Cvarc-Xtal/xiegu_g90_panel/esp32s3-panel-xiegu-g90.pdf

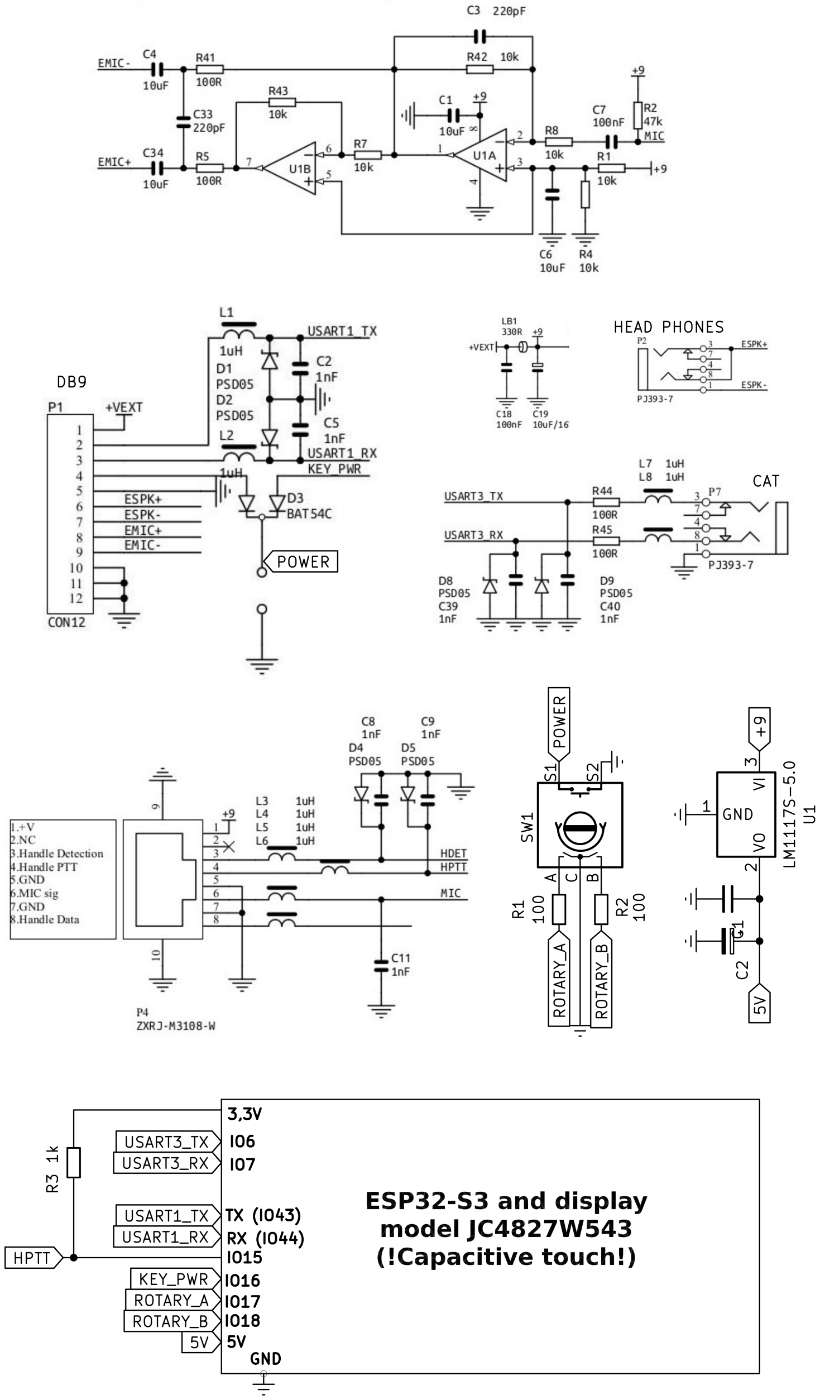
[picture p5: page 1]
