Cvarc-Xtal/xiegu_g90_panel/arduino/esp32-s3-g90-xiegu-full/JC4827W543/JC4827W543-2.png

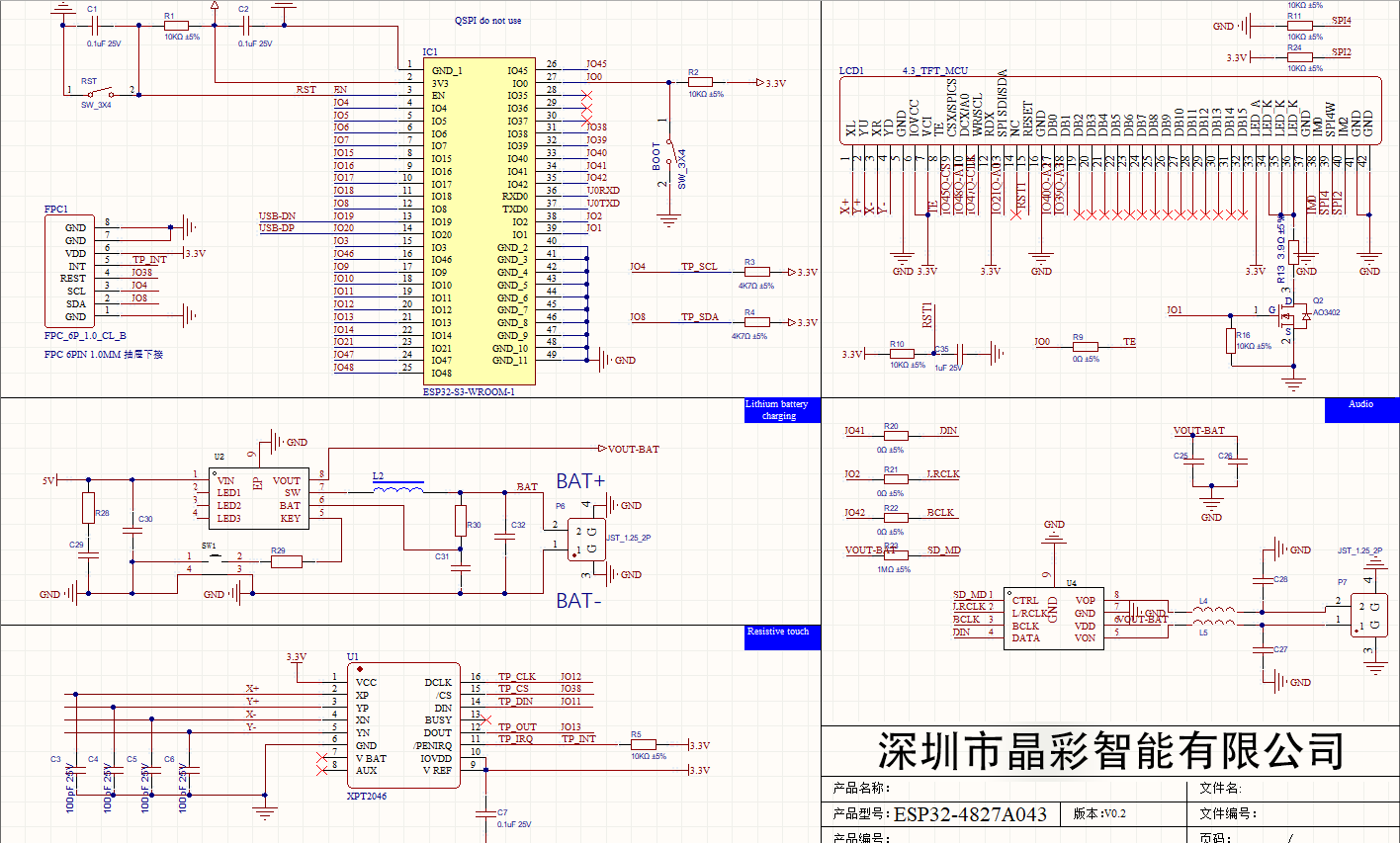
arduino/esp32-s3-g90-xiegu-full/JC4827W543/JC4827W543-2.png
