Cvarc-Xtal/xiegu_g90_panel/(threads)

Thread 1 (2025-02-13):

[program] Можно ли достичь добавления функций FT8, декодирования и кодирования.

icivon, 2025-02-13:
Можно ли достичь добавления функций FT8, декодирования и кодирования. Эта программа, функция декодирования CW все еще существует?

icivon, 2025-02-14:
Этот проект очень хороший, и я думаю, что он может заменить GSOC. Я также использую радио xiegu g90.

Cvarc-Xtal, 2025-02-14:
> Этот проект очень хороший, и я думаю, что он может заменить GSOC. Я также использую радио xiegu g90.

Да, в планах на основе этого проекта сделать почти  полноценный аналог GSOC с полосой до 100 кгц и нормальной панорамой. Изучив принципиальную схему g90, понял, что это возможно и не очень сложно.

icivon, 2025-02-14:
Недавно я искал информацию о Xiegu G90 и обнаружил этот проект. Чувствую себя очень хорошо. Хотелось бы попробовать изготовить. В последнее время изучается компиляция программы Arduion. У вас есть электронная почта, можно ли общаться друг с другом по электронной почте? Содержание здесь открыто и не подходит для частого общения.

Cvarc-Xtal, 2025-02-14:
> Недавно я искал информацию о Xiegu G90 и обнаружил этот проект. Чувствую себя очень хорошо. Хотелось бы попробовать изготовить. В последнее время изучается компиляция программы Arduion. У вас есть электронная почта, можно ли общаться друг с другом по электронной почте? Содержание здесь открыто и не подходит для частого общения.

Пишите сюда. По возможности отвечу.

icivon, 2025-02-14:
Ну, как радиолюбитель, приятно общаться с вами по технологиям. Спасибо, что поделились. Надеемся, что проект станет лучше. Если у меня возникнут проблемы с производством, я надеюсь, что вы поможете. - Спасибо. 73
