Cvarc-Xtal/xiegu_g90_panel/arduino/esp32-s3-g90-xiegu-full/include/images.h

// 'wifi-8x', 15x15px
const uint16_t wifi_on [] PROGMEM = {
  0x07e0, 0x1582, 0x15a2, 0x15a2, 0x15a2, 0x15a2, 0x15a2, 0x15a2, 0x15a2, 0x15a2, 0x15a2, 0x15a2, 0x0dc1, 0x0540, 0x0000, 0x15a2, 
  0x15a2, 0x15a2, 0x15a2, 0x15a2, 0x15a2, 0x15a2, 0x15a2, 0x15a2, 0x15a2, 0x15a2, 0x15a2, 0x15a2, 0x15a2, 0x04c0, 0x15a2, 0x15a2, 
  0x15a2, 0x15a2, 0x15a2, 0x15a2, 0x0dc1, 0x0d81, 0x1582, 0x15c2, 0x15a2, 0x15a2, 0x15a2, 0x15a2, 0x0d81, 0x15a2, 0x15a2, 0x15c2, 
  0x0000, 0x0000, 0x0000, 0x0000, 0x0000, 0x0000, 0x0000, 0x0000, 0x0dc1, 0x15a2, 0x15a2, 0x0540, 0x0000, 0x0000, 0x0000, 0x0000, 
  0x0000, 0x0000, 0x0000, 0x0000, 0x0000, 0x0000, 0x0000, 0x0000, 0x0000, 0x0000, 0x0000, 0x0000, 0x0000, 0x0400, 0x0da1, 0x15c2, 
  0x15a2, 0x15a2, 0x15a2, 0x15a2, 0x15a2, 0x15a2, 0x0540, 0x0000, 0x0000, 0x0000, 0x0000, 0x0000, 0x1562, 0x15a2, 0x15a2, 0x15a2, 
  0x15a2, 0x15a2, 0x15a2, 0x15a2, 0x15a2, 0x15c2, 0x0000, 0x0000, 0x0000, 0x0000, 0x0000, 0x0d61, 0x15a2, 0x15a2, 0x15a2, 0x15a2, 
  0x15a2, 0x15a2, 0x15a2, 0x15a2, 0x1582, 0x0000, 0x0000, 0x0000, 0x0000, 0x0000, 0x0540, 0x15c2, 0x15a2, 0x15a2, 0x15e2, 0x15e2, 
  0x15c2, 0x15a2, 0x15a2, 0x04c0, 0x0000, 0x0000, 0x0000, 0x0000, 0x0000, 0x0000, 0x0000, 0x0000, 0x0000, 0x0000, 0x0000, 0x0000, 
  0x0000, 0x0000, 0x0000, 0x0000, 0x0000, 0x0000, 0x0000, 0x0000, 0x0000, 0x0000, 0x0000, 0x0000, 0x0000, 0x0000, 0x0000, 0x0000, 
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
  0x0000, 0x0000, 0x0000, 0x0000, 0x0000, 0x0000, 0x0000, 0x0000, 0x0000, 0x0000, 0x0000, 0x0000, 0x0000, 0x0000, 0x0000, 0x0000, 
  0x0000, 0x0000, 0x0000, 0x0000, 0x0000, 0x0000, 0x0000, 0x0000, 0x0000, 0x0000, 0x0000, 0x0000, 0x0000, 0x0000, 0x0000, 0x0000, 
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
};
