Cvarc-Xtal/xiegu_g90_panel/(commit log)

2025-02-04 new file: esp32s3-panel-xiegu-g90.pdf
2025-02-04 new file: 1.png new file: 2.png modified: README.md deleted: arduino/esp32s3-panel-xiegu-g90.pdf
2025-02-04 modified: README.md deleted: arduino/esp32s3-panel-xiegu-g90.pdf
2025-02-11 modified: arduino/esp32-s3-g90-xiegu-full/fft.h modified: arduino/esp32-s3-g90-xiegu-full/g90.h modified: arduino/esp32-s3-g90-xiegu-full/global.h modified: arduino/esp32-s3-g90-xiegu-full/screens.h 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
2025-02-12 modified: arduino/esp32-s3-g90-xiegu-full/esp32-s3-g90-xiegu-full.ino modified: arduino/esp32-s3-g90-xiegu-full/g90.h modified: arduino/esp32-s3-g90-xiegu-full/global.h modified: arduino/esp32-s3-g90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
2025-02-13 modified: README.md modified: arduino/esp32-s3-g90-xiegu-full/esp32-s3-g90-xiegu-full.ino modified: arduino/esp32-s3-g90-xiegu-full/tools.h
2025-02-13 modified: arduino/esp32-s3-g90-xiegu-full/screens.h
2025-02-19 modified: arduino/esp32-s3-g90-xiegu-full/_tmp.h modified: arduino/esp32-s3-g90-xiegu-full/ci_v.h modified: arduino/esp32-s3-g90-xiegu-full/esp32-s3-g90-xiegu-full.ino modified: arduino/esp32-s3-g90-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
